dfsbora/cm201/README.md

<h1 align="center">CM-201 Projeto e Fabricação de Robôs Móveis</h1>
<p align="center">Laboratórios</p>

## Requisitos
KiCad 5.1.1 

Grupo 02.
