dfsbora/cm201/(list of files, cad)

Other CAD files:
aula03/Bateria.CATPart
aula03/micro-gearmotor-mounting-encoder.CATPart
aula03/parafuso.CATPart
aula03/roda.CATPart
