dfsbora/cm201/aula03/CMC10-VSS-BottomBody-Anotado.pdf

E | E
F | F

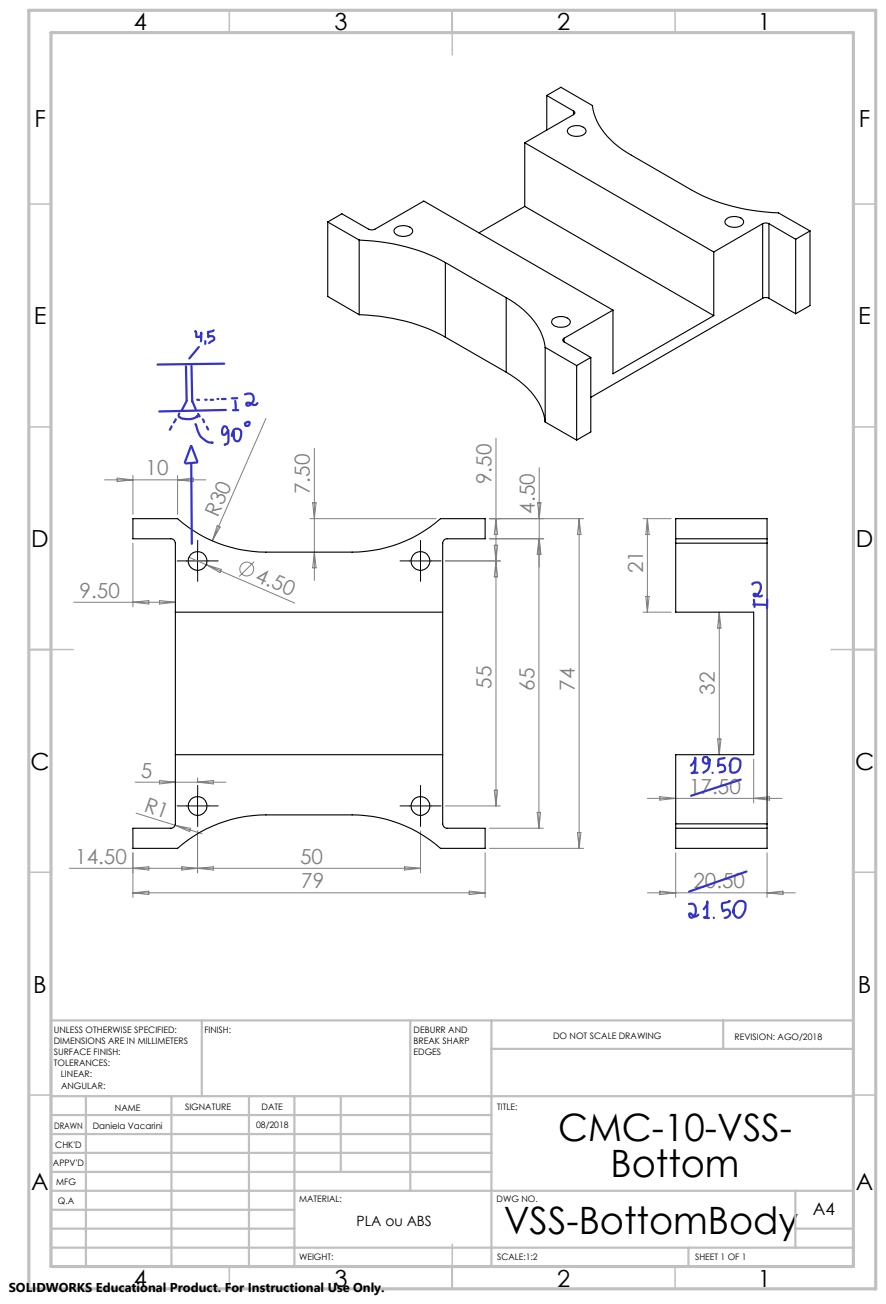
[picture p1: page 1]
FINISH:; DEBURR AND; BREAK SHARP EDGES; DO NOT SCALE DRAWING; REVISION: AGO/2018; SCALE:1:2; SHEET 1 OF 1; WEIGHT:

UNLESS OTHERWISE SPECIFIED:
DIMENSIONS ARE IN MILLIMETERS
SURFACE FINISH:
TOLERANCES:
LINEAR:
ANGULAR:

NAME | SIGNATURE | DATE | | | | TITLE: CMC-10-VSS-Bottom

DRAWN | Daniela Vacarini | | 08/2018
CHK'D
APPV'D
MFG
Q.A | | | | MATERIAL: PLA ou ABS | DWG NO. VSS-BottomBody | A4

SOLIDWORKS Educational Product. For Instructional Use Only.
