dfsbora/cm201/aula03/CMC10-VSS-UpperBody-Anotado.pdf

E | E
F | F

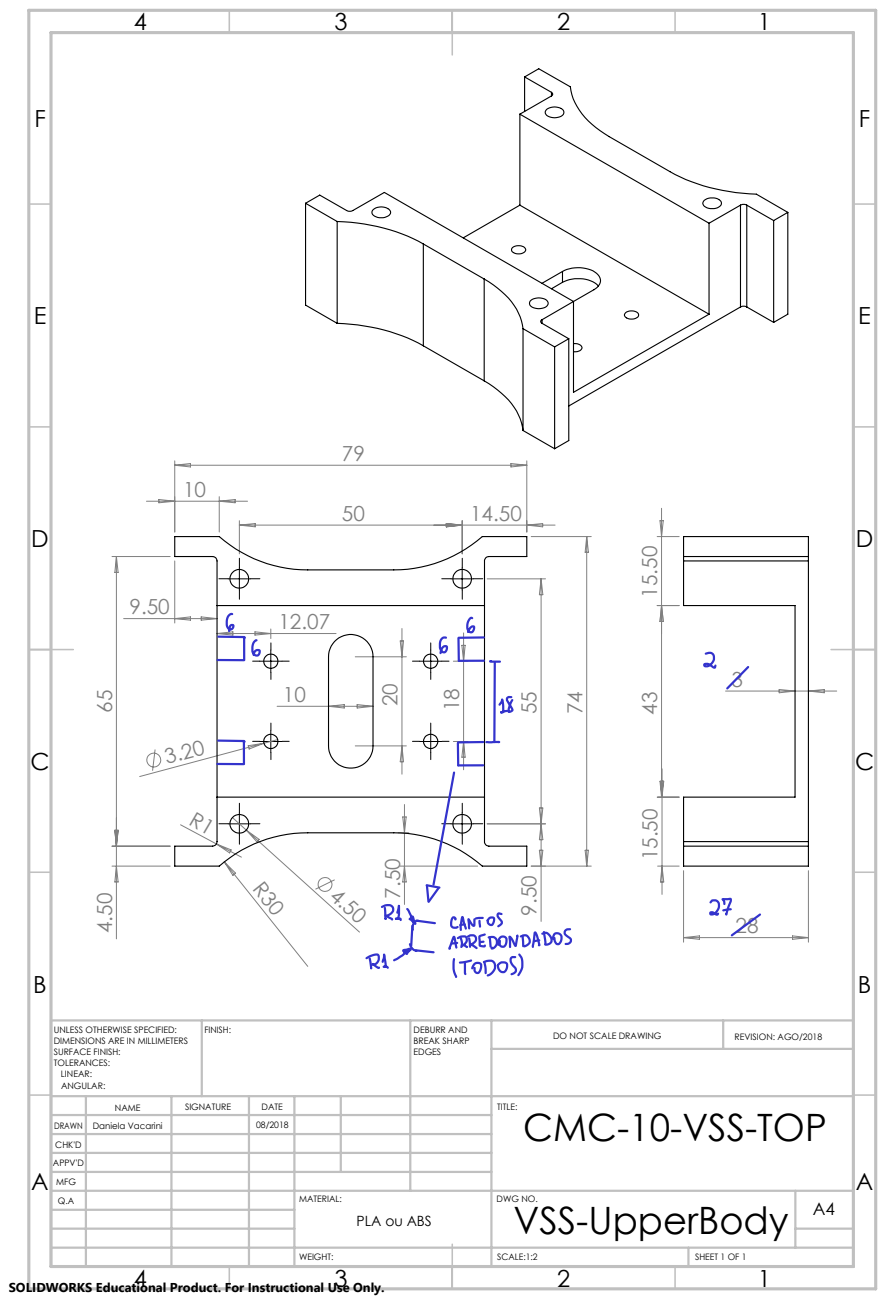
[picture p2: page 1]
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

UNLESS OTHERWISE SPECIFIED:
DIMENSIONS ARE IN MILLIMETERS
SURFACE FINISH:
TOLERANCES:
LINEAR:
ANGULAR:

NAME | SIGNATURE | DATE | | | | TITLE: CMC-10-VSS-TOP

DRAWN | Daniela Vacarini | | 08/2018
CHK'D
APPV'D
MFG
Q.A | | | | MATERIAL: PLA ou ABS | DWG NO. VSS-UpperBody | A4

SOLIDWORKS Educational Product. For Instructional Use Only.
