dfsbora/cm201/(list of files, drawings)

Other design files:
aula02/vss.dsn
