dfsbora/cm201/aula02/vss.kicad_pcb

## KiCad design aula02/vss.kicad_pcb (2021-08-25)

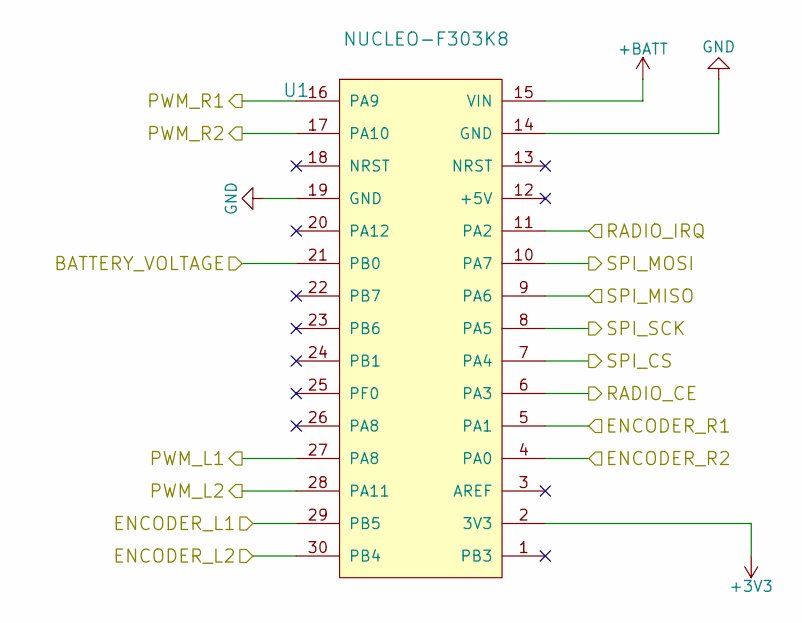
[picture p3: schematic microcontroller.sch]

Parts:
U1: NUCLEO-F303K8; NUCLEO-F3

Connections:
+BATT: U1.15 (VIN); also elsewhere on the board
/Microcontroller/BATTERY_VOLTAGE: U1.21 (PB0); also elsewhere on the board
/MotorL/ENCODER_1: U1.29 (PB5); also elsewhere on the board
/MotorL/ENCODER_2: U1.30 (PB4); also elsewhere on the board
/MotorL/PWM_1: U1.27 (PA8); also elsewhere on the board
/MotorL/PWM_2: U1.28 (PA11); also elsewhere on the board
/MotorR/ENCODER_1: U1.5 (PA1); also elsewhere on the board
/MotorR/ENCODER_2: U1.4 (PA0); also elsewhere on the board
/MotorR/PWM_1: U1.16 (PA9); also elsewhere on the board
/MotorR/PWM_2: U1.17 (PA10); also elsewhere on the board
/Radio/CE: U1.6 (PA3); also elsewhere on the board
/Radio/CSN: U1.7 (PA4); also elsewhere on the board
/Radio/IRQ: U1.11 (PA2); also elsewhere on the board
/Radio/MISO: U1.9 (PA6); also elsewhere on the board
/Radio/MOSI: U1.10 (PA7); also elsewhere on the board
/Radio/SCK: U1.8 (PA5); also elsewhere on the board
GND: U1.14 (GND), U1.19 (GND); also elsewhere on the board

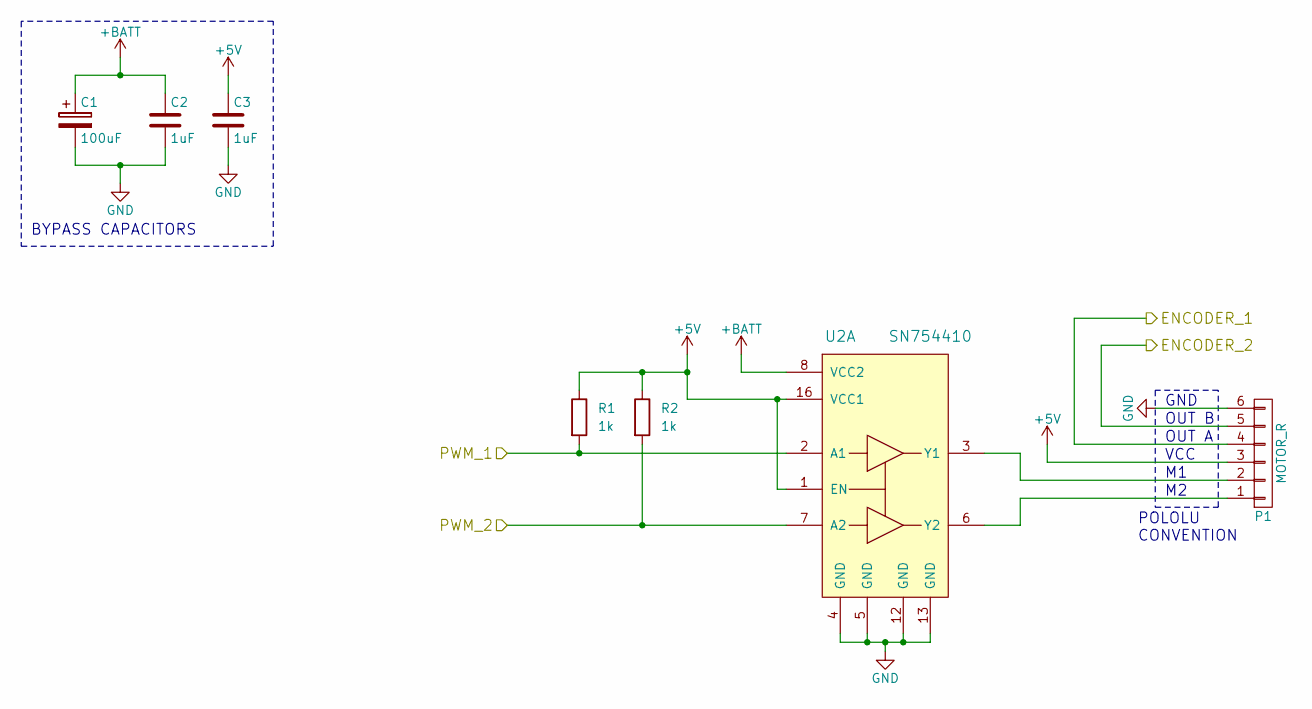
[picture p4: schematic motorL.sch]

Parts:
C1: 100uF; CP_Radial_D6.3mm_P2.50mm
C2, C3: 1uF; C_0805_2012Metric_Pad1.15x1.40mm_HandSolder
P1: MOTOR_R; PinHeader_1x06_P2.54mm_Horizontal
R1, R2: 1k; R_1206_3216Metric_Pad1.42x1.75mm_HandSolder
U2: SN754410; DIP-16_W7.62mm_Socket_LongPads

Connections:
+5V: C3.1, P1.3, R1.1, R2.1, U2.1 (EN), U2.16 (VCC1); also elsewhere on the board
+BATT: C1.1, C2.1, U2.8 (VCC2); also elsewhere on the board
/MotorL/ENCODER_1: P1.4; also elsewhere on the board
/MotorL/ENCODER_2: P1.5; also elsewhere on the board
/MotorL/PWM_1: R1.2, U2.2 (A1); also elsewhere on the board
/MotorL/PWM_2: R2.2, U2.7 (A2); also elsewhere on the board
GND: C1.2, C2.2, C3.2, P1.6, U2.4 (GND), U2.5 (GND), U2.12 (GND), U2.13 (GND); also elsewhere on the board
unnamed: P1.1, U2.6 (Y2)
unnamed: P1.2, U2.3 (Y1)

Notes on the sheet:
BYPASS CAPACITORS
VCC
OUT A
OUT B
GND
POLOLU CONVENTION

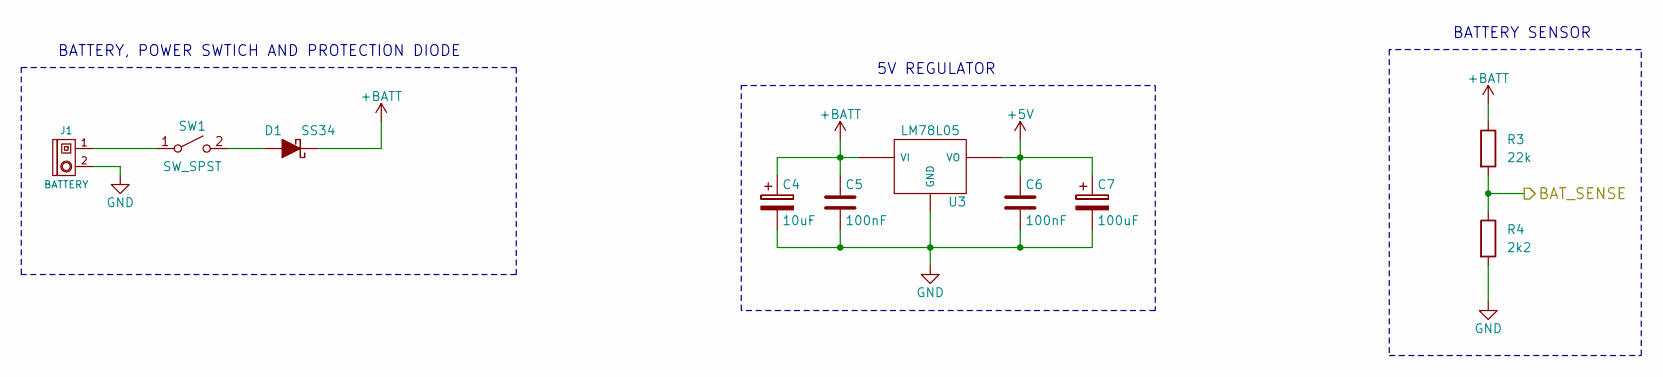
[picture p5: schematic Power.sch]

Parts:
C4: 10uF; CP_Radial_D4.0mm_P2.00mm
C5, C6: 100nF; C_1206_3216Metric_Pad1.42x1.75mm_HandSolder
C7: 100uF; CP_Radial_D6.3mm_P2.50mm
D1: SS34; D_SMB_Handsoldering
J1: BATTERY; PinHeader_1x02_P2.54mm_Horizontal
R3: 22k; R_1206_3216Metric_Pad1.42x1.75mm_HandSolder
R4: 2k2; R_1206_3216Metric_Pad1.42x1.75mm_HandSolder
SW1: SW_SPST; PRK22J5DBBNN
U3: LM78L05; SOT-89-3_Handsoldering

Connections:
+5V: C6.1, C7.1, U3.1 (VO); also elsewhere on the board
+BATT: C4.1, C5.1, D1.1 (K), R3.1, U3.3 (VI); also elsewhere on the board
/Microcontroller/BATTERY_VOLTAGE: R3.2, R4.1; also elsewhere on the board
GND: C4.2, C5.2, C6.2, C7.2, J1.2, R4.2, U3.2 (GND); also elsewhere on the board
unnamed: D1.2 (A), SW1.2 (B)
unnamed: J1.1, SW1.1 (A)

Notes on the sheet:
BATTERY SENSOR
BATTERY, POWER SWTICH AND PROTECTION DIODE
5V REGULATOR

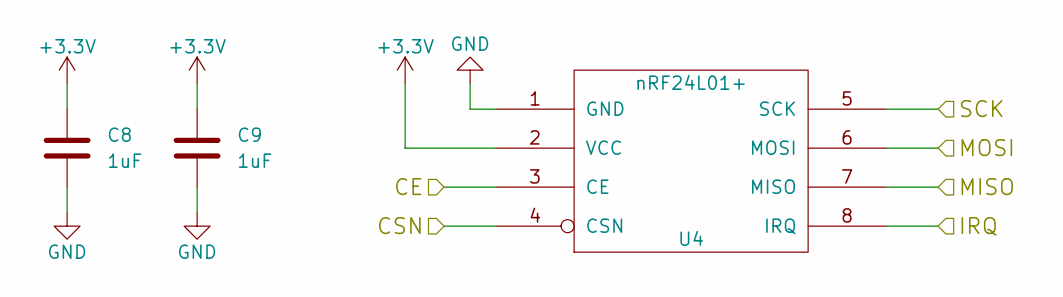
[picture p6: schematic radio.sch]

Parts:
C8, C9: 1uF; C_0805_2012Metric_Pad1.15x1.40mm_HandSolder
U4: nRF24L01+; NRF24L01

Connections:
/Radio/CE: U4.3 (CE); also elsewhere on the board
/Radio/CSN: U4.4 (CSN); also elsewhere on the board
/Radio/IRQ: U4.8 (IRQ); also elsewhere on the board
/Radio/MISO: U4.7 (MISO); also elsewhere on the board
/Radio/MOSI: U4.6 (MOSI); also elsewhere on the board
/Radio/SCK: U4.5 (SCK); also elsewhere on the board
GND: C8.2, C9.2, U4.1 (GND); also elsewhere on the board

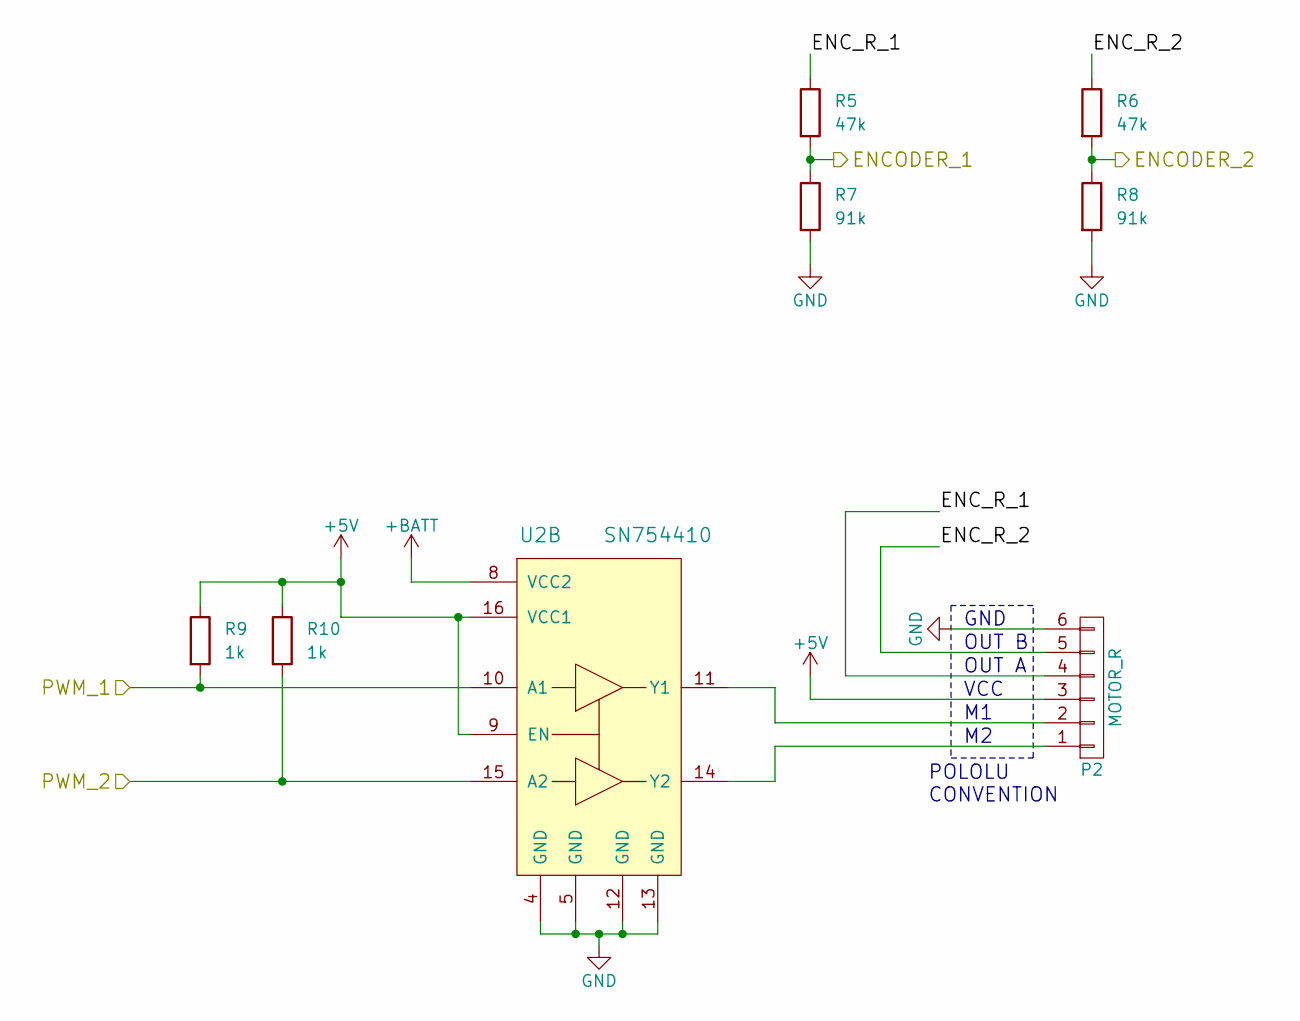
[picture p7: schematic motorR.sch]

Parts:
P2: MOTOR_R; PinHeader_1x06_P2.54mm_Horizontal
R5, R6: 47k; R_1206_3216Metric_Pad1.42x1.75mm_HandSolder
R7, R8: 91k; R_1206_3216Metric_Pad1.42x1.75mm_HandSolder
R9, R10: 1k; R_1206_3216Metric_Pad1.42x1.75mm_HandSolder
U2: SN754410; DIP-16_W7.62mm_Socket_LongPads

Connections:
+5V: P2.3, R9.1, R10.1, U2.9 (EN), U2.16 (VCC1); also elsewhere on the board
+BATT: U2.8 (VCC2); also elsewhere on the board
/MotorR/ENCODER_1: R5.2, R7.1; also elsewhere on the board
/MotorR/ENCODER_2: R6.2, R8.1; also elsewhere on the board
/MotorR/ENC_R_1: P2.4, R5.1
/MotorR/ENC_R_2: P2.5, R6.1
/MotorR/PWM_1: R9.2, U2.10 (A1); also elsewhere on the board
/MotorR/PWM_2: R10.2, U2.15 (A2); also elsewhere on the board
GND: P2.6, R7.2, R8.2, U2.4 (GND), U2.5 (GND), U2.12 (GND), U2.13 (GND); also elsewhere on the board
unnamed: P2.1, U2.14 (Y2)
unnamed: P2.2, U2.11 (Y1)

Notes on the sheet:
VCC
OUT A
OUT B
GND
POLOLU CONVENTION

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
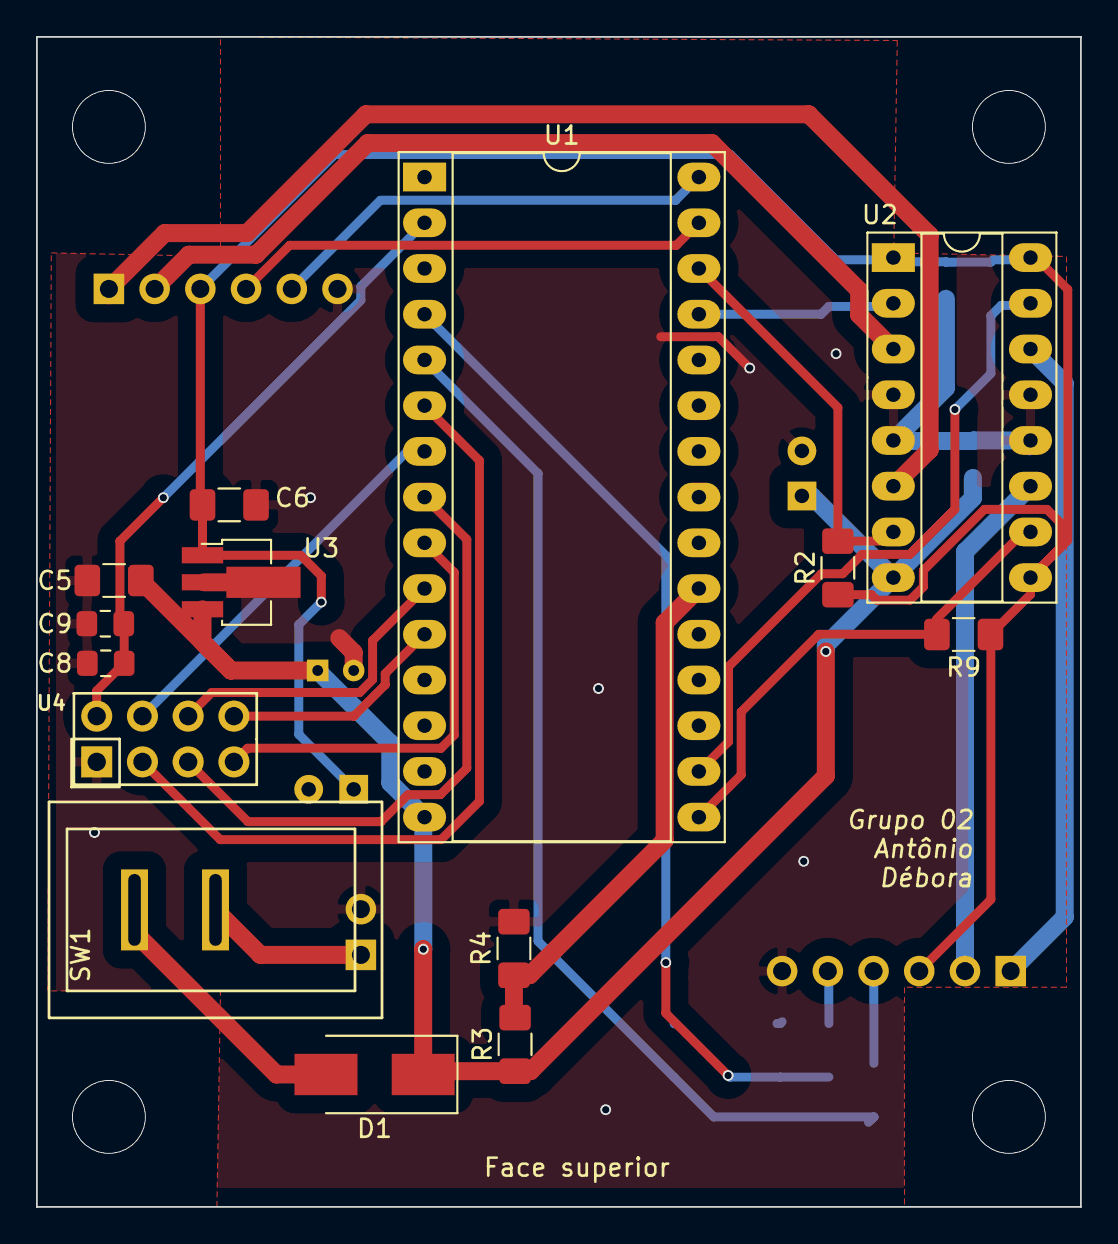
[picture p8: board vss.kicad_pcb from above]

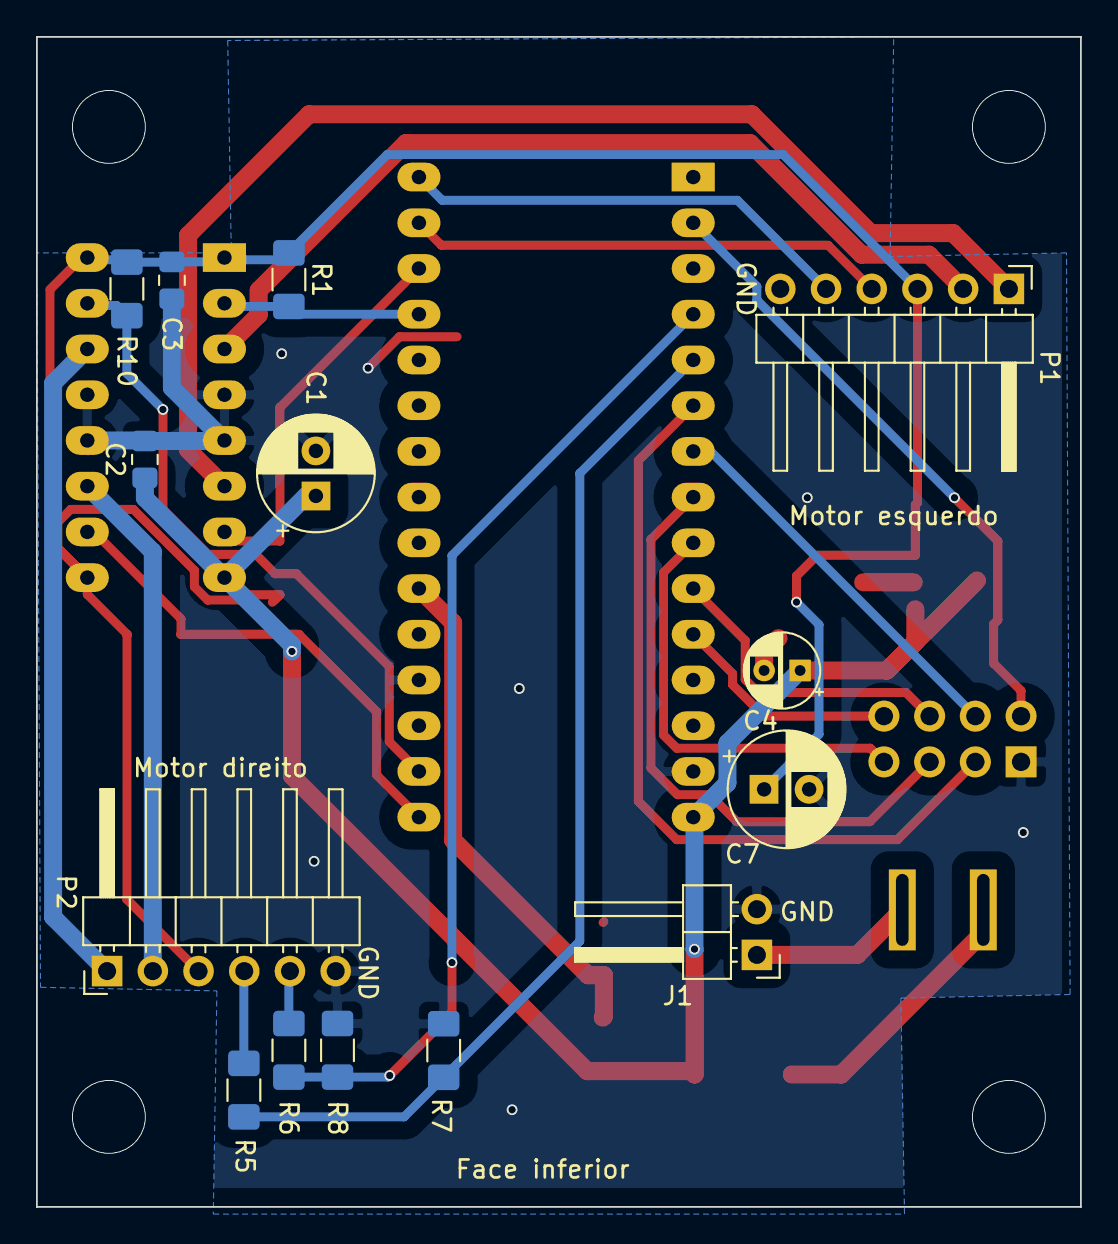
[picture p9: board vss.kicad_pcb from below]

Board: 2 copper layers, 58.0 x 65.0 mm, 28 parts (14 on the bottom side), 27 nets.
