dfsbora/cm201/aula02/cubemx_microcontrolador.ioc

Mcu.UserName=STM32F303K8Tx
PA0.GPIO_Label=ENCODER_R1
PA0.Signal=S_TIM2_CH1_ETR
PA1.GPIO_Label=ENCODER_R2
PA1.Signal=S_TIM2_CH2
PA10.GPIO_Label=PWM_R2
PA10.Signal=S_TIM1_CH3
PA11.GPIO_Label=PWM_L2
PA11.Signal=S_TIM1_CH4
PA2.GPIO_Label=RADIO_IRQ
PA2.Signal=GPXTI2
PA3.GPIO_Label=RADIO_CE
PA3.Signal=GPIO_Output
PA4.GPIO_Label=SPI_CS
PA4.Signal=GPIO_Output
PA5.GPIO_Label=SPI_SCK
PA5.Signal=SPI1_SCK
PA6.GPIO_Label=SPI_MISO
PA6.Signal=SPI1_MISO
PA7.GPIO_Label=SPI_MOSI
PA7.Signal=SPI1_MOSI
PA8.GPIO_Label=PWM_L1
PA8.Signal=S_TIM1_CH1
PA9.GPIO_Label=PWM_R1
PA9.Signal=S_TIM1_CH2
PB0.Signal=ADC1_IN11
PB4.GPIO_Label=ENCODER_L2
PB4.Signal=S_TIM3_CH1
PB5.GPIO_Label=ENCODER_L1
PB5.Signal=S_TIM3_CH2
