dfsbora/cm201/(commit log)

2021-08-14 add: pcb design v1
    [Power-2018-08-06-20-02-10.sch, Power.sch, PowerBak.sch, SignalProcessing.sch, hbridge.sch, microcontroller-2018-08-06-20-02-10.sch, microcontroller.sch, motor1.sch]
2021-08-14 feat: pcb roteamento
    [vss.kicad_pcb]
2021-08-14 fix: roteamento motor
    [vss.kicad_pcb]
2021-08-17 add: CAT files
    [Bateria.CATPart, micro-gearmotor-mounting-encoder.CATPart, parafuso.CATPart, roda.CATPart]
2021-08-20 fix: plano de ground
    [vss.kicad_pcb]
2021-08-20 fix: vias
    [vss.kicad_pcb]
2021-08-20 fix: posicao capacitor e planos de ground
    [vss.kicad_pcb]
2021-08-25 fix: R9 location
    [vss.kicad_pcb]
2021-08-25 fix: components under radio and filled zones
    [vss.kicad_pcb]
